jason0925pig-rgb/Term3-Robotic-Challenge/Robotic_Challenge/test/Debug output/easy_strategy_debug.txt

this is the output from teh debug, it's not executing the drive 2 staright, it runs left early

[LINE] mode=FOLLOW detected=YES active=7 pos=3822 err=-178 L=259 R=541
[LINE] mode=FOLLOW detected=YES active=7 pos=3883 err=-117 L=307 R=493
[LINE] mode=FOLLOW detected=YES active=7 pos=3959 err=-41 L=373 R=427
[LINE] mode=FOLLOW detected=YES active=7 pos=3997 err=-3 L=402 R=398
[LINE] mode=FOLLOW detected=YES active=7 pos=4026 err=26 L=421 R=379
[LINE] mode=FOLLOW detected=YES active=7 pos=3983 err=-17 L=384 R=416
[LINE] mode=FOLLOW detected=YES active=7 pos=4029 err=29 L=424 R=376
[RFID] uid=2802AB41 mapped=x=9 y=8 navigation=ignored
[SERVER] sent type=isFertile team_id=2 board_id=Yu7GT tag_id=2802AB41 ok=YES
[SERVER] reply fertile=true planted=true cell=x=1 y=8
[PLANT] skip uid=2802AB41 fertile=true planted=true seedsRemaining=4
[LINE] mode=FOLLOW detected=YES active=7 pos=4003 err=3 L=400 R=400
[LINE] mode=FOLLOW detected=YES active=7 pos=4023 err=23 L=421 R=379
[LINE] mode=FOLLOW detected=YES active=7 pos=4021 err=21 L=419 R=381
[LINE] mode=FOLLOW detected=YES active=7 pos=3714 err=-286 L=172 R=628
[LINE] mode=FOLLOW detected=YES active=7 pos=3782 err=-218 L=232 R=568
[LINE] mode=FOLLOW detected=YES active=7 pos=4447 err=447 L=752 R=48
[LINE] mode=FOLLOW detected=YES active=7 pos=4049 err=49 L=444 R=356
[LINE] mode=FOLLOW detected=YES active=7 pos=3951 err=-49 L=361 R=439
[LINE] mode=FOLLOW detected=YES active=7 pos=3898 err=-102 L=321 R=479
[LINE] mode=FOLLOW detected=YES active=7 pos=3914 err=-86 L=336 R=464
[LINE] mode=FOLLOW detected=YES active=7 pos=3961 err=-39 L=368 R=432
[LINE] mode=FOLLOW detected=YES active=7 pos=3991 err=-9 L=395 R=405
[LINE] mode=FOLLOW detected=YES active=7 pos=3969 err=-31 L=376 R=424
[LINE] mode=FOLLOW detected=YES active=7 pos=3873 err=-127 L=298 R=502
[LINE] mode=FOLLOW detected=YES active=7 pos=3879 err=-121 L=305 R=495
[LINE] mode=FOLLOW detected=YES active=7 pos=3883 err=-117 L=306 R=494
[LINE] mode=FOLLOW detected=YES active=7 pos=3868 err=-132 L=297 R=503
[LINE] mode=FOLLOW detected=YES active=7 pos=3893 err=-107 L=317 R=483
[LINE] mode=FOLLOW detected=YES active=7 pos=3880 err=-120 L=303 R=497
[LINE] mode=FOLLOW detected=YES active=7 pos=3890 err=-110 L=316 R=484
[EASY] error: script_failed
[EASY] state=ERROR
[DONE] Easy mission stopped in ERROR. Reset or upload a fix to run again.
