jason0925pig-rgb/Term3-Robotic-Challenge/Robotic_Challenge/test/I2C_Scanner_Test/I2C_Scanner_Test.ino

#include <Arduino.h>
#include <Wire.h>

// ---------------------------------------------------------------------------
// I2C scanner for Arduino GIGA.
// Wire scans D20/D21. Wire1 scans the shield SDA1/SCL1 bus.
// Current robot:
//   Wire  / D20-D21      -> RFID 0x28, VL53L5CX 0x29, Modulino Pixels 0x36, IMU 0x68
//   Wire1 / shield bus   -> Motoron 0x11, shield helper device 0x60
// ---------------------------------------------------------------------------

void scanBus(TwoWire &bus, const __FlashStringHelper *name) {
  uint8_t found = 0;
  Serial.print(F("Scanning "));
  Serial.println(name);

  for (uint8_t address = 1; address < 127; address++) {
    bus.beginTransmission(address);
    const uint8_t error = bus.endTransmission();

    if (error == 0) {
      Serial.print(F("Found 0x"));
      if (address < 16) Serial.print('0');
      Serial.print(address, HEX);
      if (address == 0x11) Serial.print(F("  <- Motoron M3S550 address used by tests"));
      if (address == 0x60) Serial.print(F("  <- shield helper address"));
      Serial.println();
      found++;
    } else if (error == 4) {
      Serial.print(F("Unknown error at 0x"));
      if (address < 16) Serial.print('0');
      Serial.println(address, HEX);
    }
  }

  if (found == 0) {
    Serial.print(F("No I2C devices found on "));
    Serial.println(name);
  }
  Serial.println();
}

void setup() {
  Serial.begin(115200);
  delay(1000);
  Wire.begin();
  Wire1.begin();
  Serial.println(F("I2C_Scanner_Test ready."));
}

void loop() {
  scanBus(Wire, F("Wire / D20 SDA / D21 SCL"));
  scanBus(Wire1, F("Wire1 / shield SDA1-SCL1"));
  delay(3000);
}
