jason0925pig-rgb/Term3-Robotic-Challenge/(commit log)

2026-06-01 Final obstacle avoidance test
    [basic_utils.h, declarations.h, encoder_utils.h, imu_turn_utils.h]
2026-06-01 Refactor obstacle avoidance sketch into app module
    Move the obstacle avoidance state-machine implementation into a C++ source file and expose the Arduino entrypoints through a small header. Leave the .ino file as a thin sketch wrapper that includes the app header.
    [obstacle_avoidance.cpp]
2026-06-01 Restore obstacle avoidance sketch filename
    Rename the obstacle avoidance app wrapper and module files to Obstacle_Avoidance_Test so the sketch entrypoint matches the Arduino sketch folder name.
    [Obstacle_Avoidance_Test.cpp]
2026-06-02 Tracked all files before switching back to main for cleaning up
2026-06-02 Fixed app mode for obstacle avoidance.
    Only line based atm.
    [line_based.cpp]
2026-06-03 Update base exit tunnel WiFi and status LEDs
2026-06-03 Fixed trajectory for easy diff v1
    [basic_utils.h, constants.h, declarations.h, easy_controller.h, easy_difficulty.cpp, easy_navigation.h, easy_planting.h]
2026-06-03 Integrate base exit with fixed RFID planting route
    [Base_Exit_Tunnel_Wall_Test.ino]
